MarcelMG/Heterodyne_Bat_Detector/README.md

# Heterodyne_Bat_Detector
A Bat Detector of the heterodyne type that let's you listen to the ultrasonic sounds from bats in real-time.

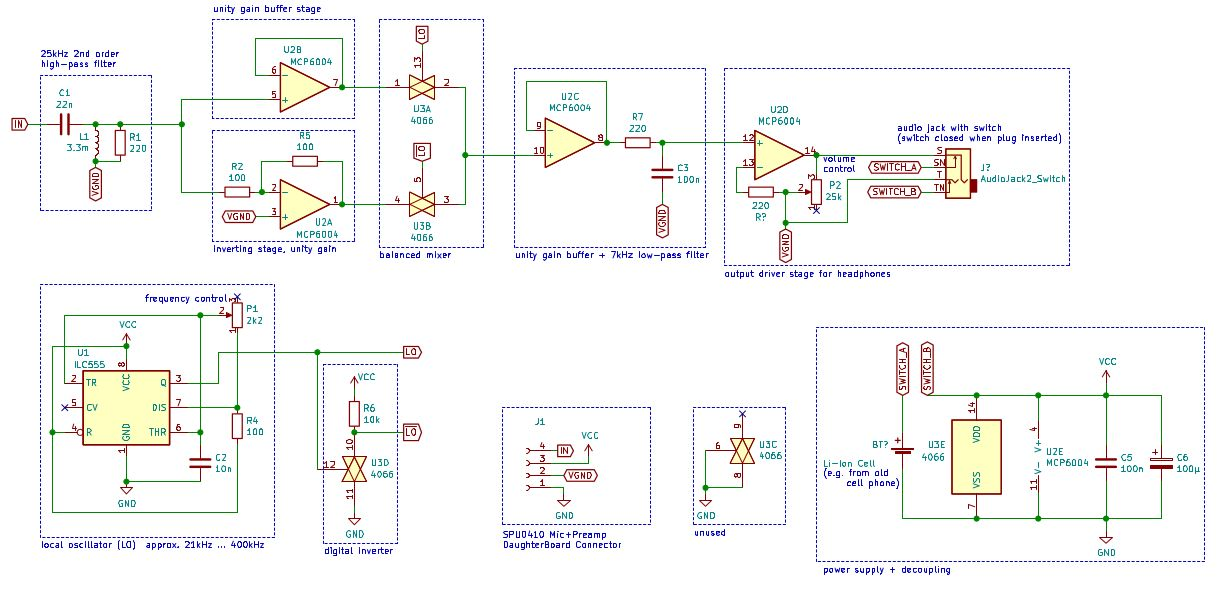
[picture p1: schematic_small.jpg]
schematic


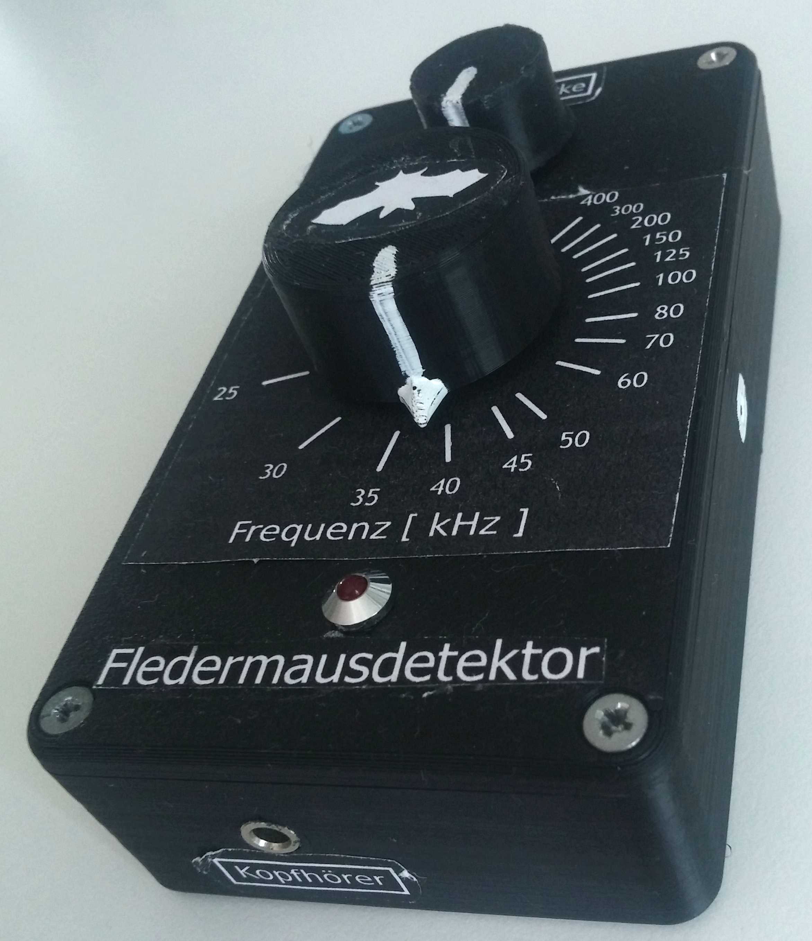
[picture p2: bat_detector_image1.jpg]
