MarcelMG/Heterodyne_Bat_Detector/simulation/simulation1.jpg

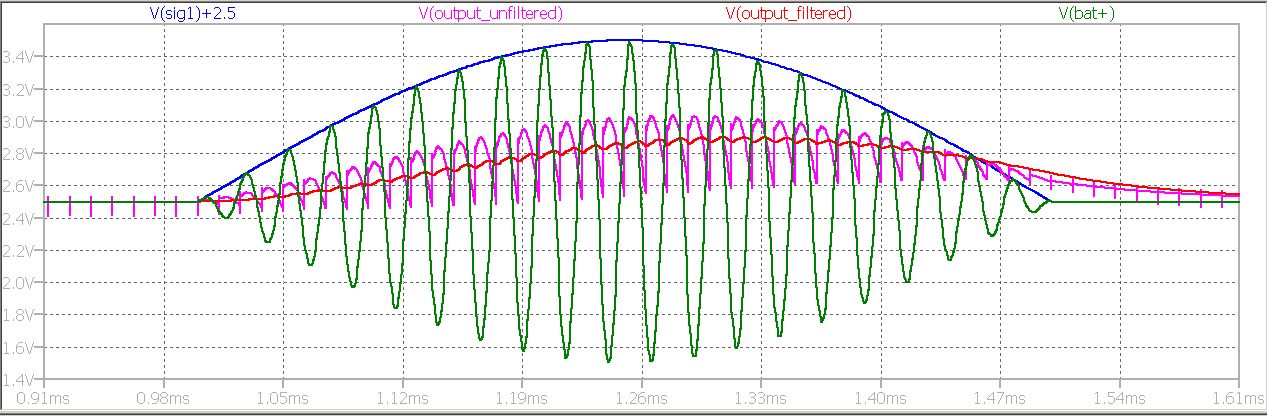
simulation/simulation1.jpg
