MarcelMG/Heterodyne_Bat_Detector/Bat_detector.pdf

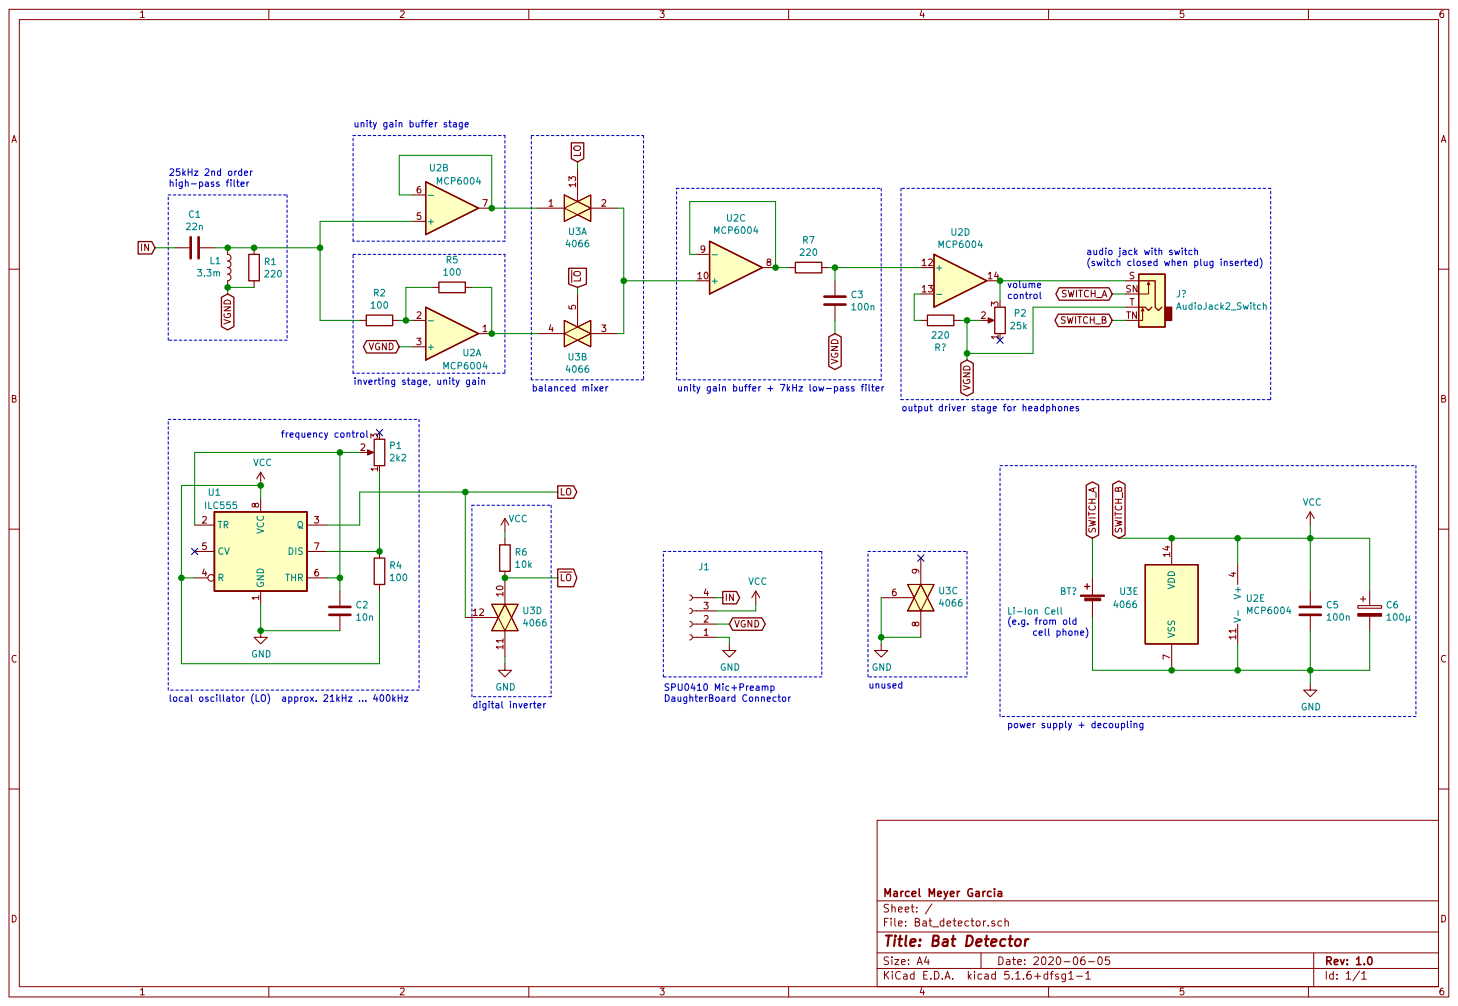
[picture p4: page 1]

unity gain buffer stage

(switch closed when plug inserted) 25kHz 2nd order high-pass filter

audio jack with switch

inverting stage, unity gain

unity gain buffer + 7kHz low-pass filter

output driver stage for headphones

VCC

File: Bat_detector.sch Sheet: / Marcel Meyer Garcia

Id: 1/1 Title: Bat Detector
