MarcelMG/Heterodyne_Bat_Detector/simulation/4066_mixer.asc

B1: bv; V=V(carrier)*V(sig1)+2.5V
B2: bv; V=-V(carrier)*V(sig1)+2.5V
C1: cap; 100n
DD1.1: CD4066
DD2: CD4066
R1: res; 220
V1: voltage; 5
V2: voltage; SINE(0 1 40k 0 0 45)
V3: voltage; PULSE(0 5 0 10n 10n 125e-7 25e-6 1e6)
V4: voltage; SINE(0 1 1k 1e-3 0 0 0.5)
V5: voltage; PULSE(5 0 0 10n 10n 125e-7 25e-6 1e6)
Named nets: 0, vcc, carrier, sig1, bat+, LO+, LO-, bat-, output_unfiltered, output_filtered
.tran 0 3e-3 0 1e-6
.lib CD4066.sub
.OPTIONS plotwinsize=0
