MarcelMG/Heterodyne_Bat_Detector/Bat_detector.sch

## KiCad design Bat_detector.sch (2020-06-18)

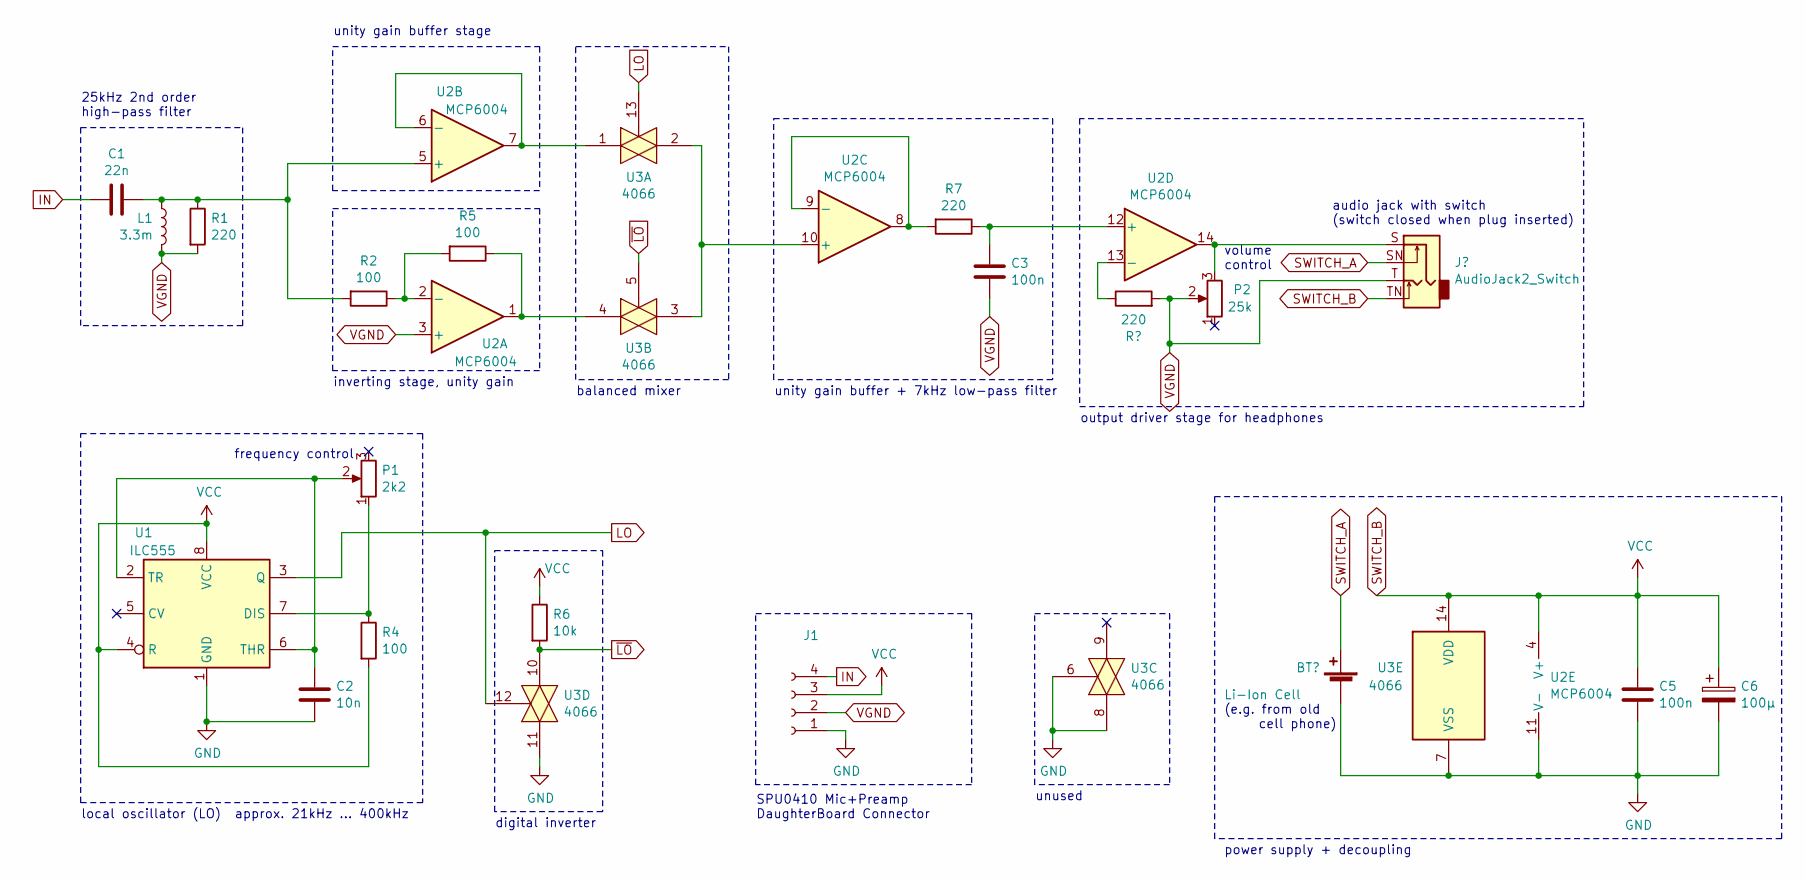
[picture p5: schematic Bat_detector.sch]

Parts:
C1: 22n
C2: 10n
C3, C5: 100n
C6: 100µ
J1: (no value)
L1: 3.3m
P1: 2k2
P2: 25k
R1, R7: 220
R2, R4, R5: 100
R6: 10k
U1: ILC555; DIP-8_W7.62mm
U2: MCP6004
U3: 4066

Connections:
GND: C2.2, C5.2, C6.2, J1.1, U1.1 (GND), U2.11 (V-), U3.6, U3.7 (VSS), U3.8, U3.11
IN: C1.2, J1.4
LO: U1.3 (Q), U3.12, U3.13
unnamed: C1.1, L1.2, R1.1, R2.2, U2.5 (+)
unnamed: C2.1, P1.2, U1.2 (TR), U1.6 (THR)
unnamed: C3.1, R7.1, U2.12 (+)
unnamed: P1.1, R4.1, U1.7 (DIS)
unnamed: P2.3, U2.14
unnamed: R2.1, R5.2, U2.2 (-)
unnamed: R5.1, U2.1, U3.4
unnamed: R7.2, U2.8, U2.9 (-)
unnamed: U2.6 (-), U2.7, U3.1
unnamed: U2.10 (+), U3.2, U3.3
SWITCH_B: C5.1, C6.1, J1.3, R4.2, R6.1, U1.4 (R), U1.8 (VCC), U2.4 (V+), U3.14 (VDD)
VGND: C3.2, J1.2, L1.1, P2.2, R1.2, U2.3 (+)
~LO: R6.2, U3.5, U3.10

Notes on the sheet:
25kHz 2nd order high-pass filter
inverting stage, unity gain
local oscillator (LO) approx. 21kHz ... 400kHz
digital inverter
unused
balanced mixer
unity gain buffer stage
unity gain buffer + 7kHz low-pass filter
output driver stage for headphones
volume control
frequency control
SPU0410 Mic+Preamp DaughterBoard Connector
power supply + decoupling
(e.g. from old cell phone)
audio jack with switch (switch closed when plug inserted)
